HB9GZE/Pub_DIY_Q_BLDCmotorcontroller/1_eagle/STM32F303CBT6_BTN8962TA_V1_0.brd

## EAGLE design 1_eagle/STM32F303CBT6_BTN8962TA_V1_0.brd (2017-02-23)

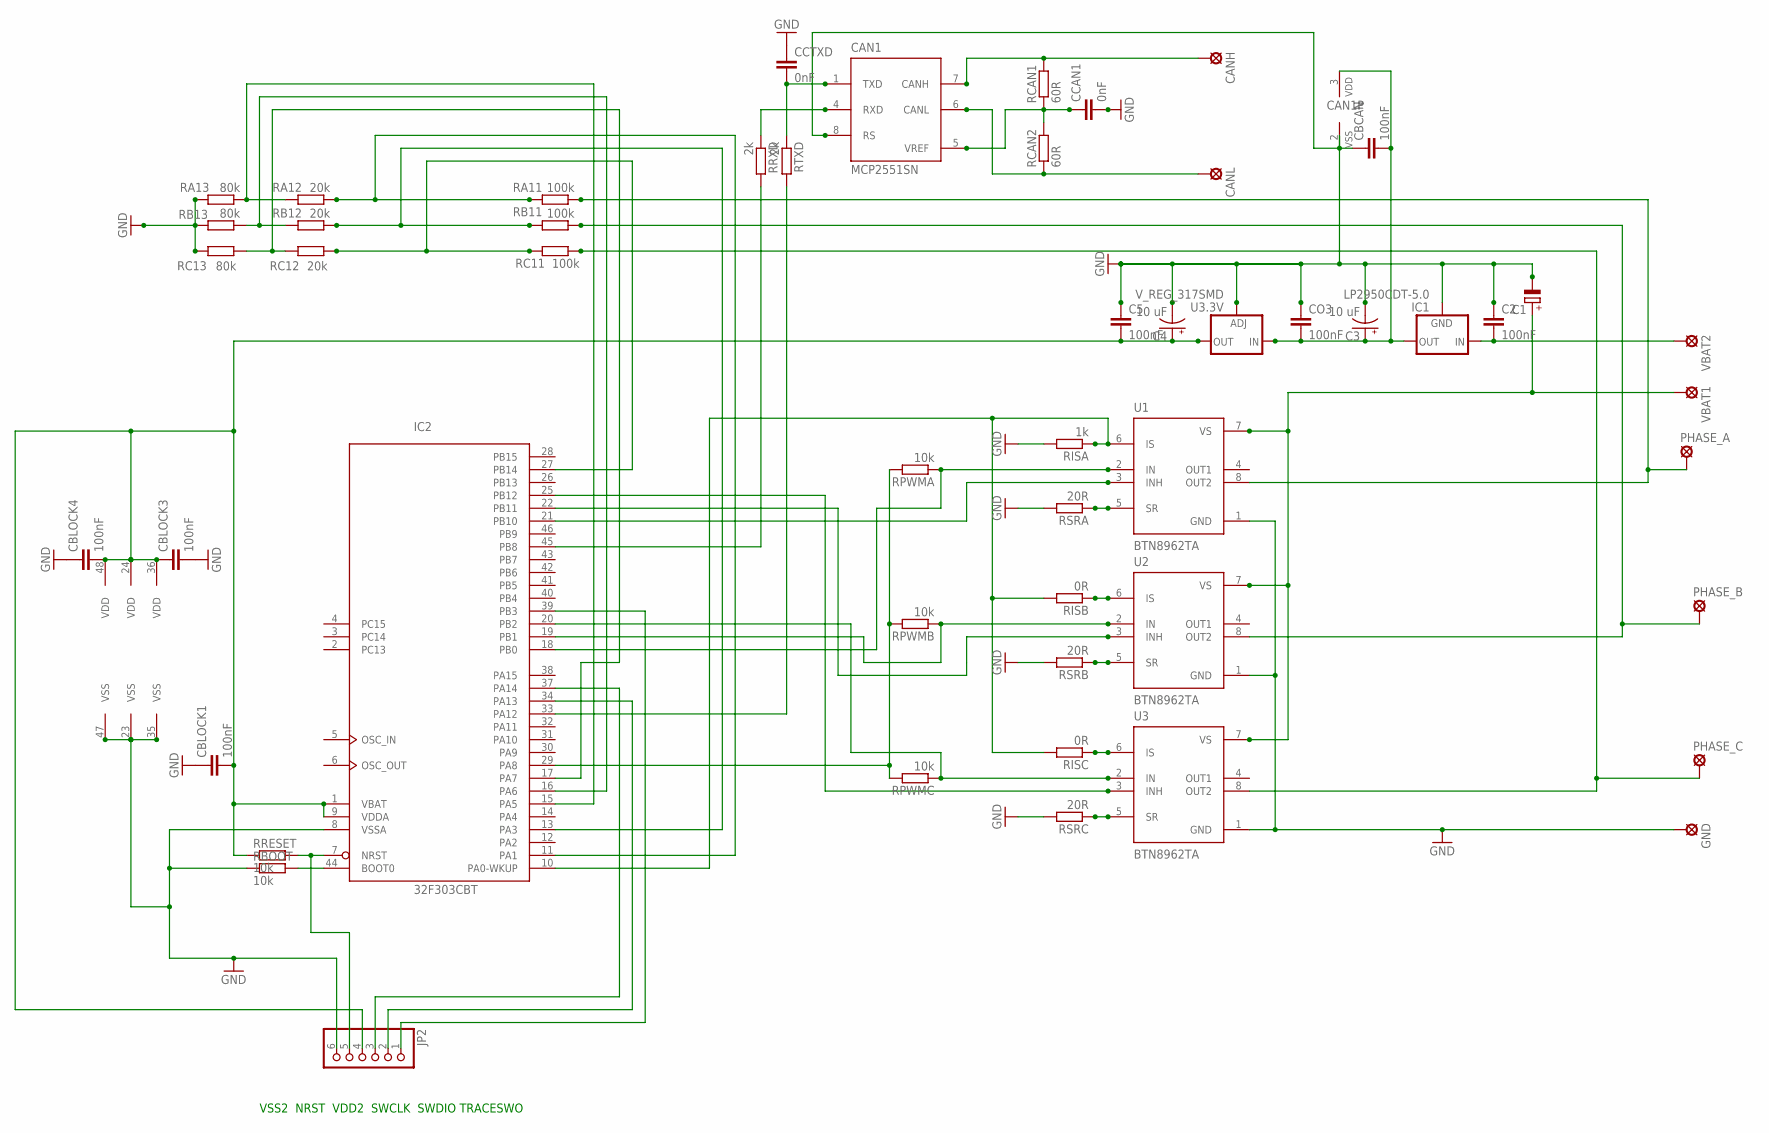
[picture p1: schematic STM32F303CBT6_BTN8962TA_V1_0.sch]

Parts:
C1: CPOL-EUE3.5-10; E3,5-10
C2, C5: 100nF; C0805
C3, C4: 10 uF; PANASONIC_D
CAN1: MCP2551SN; SO-08
CANH: LSP10
CANL: LSP10
CBCAN: 100nF; C0805
CBLOCK1, CBLOCK3, CBLOCK4: 100nF; C0805
CCAN1: 0nF; C0805
CCTXD: 0nF; C0805
CO3: 100nF; C0805
GND: SE14
IC1: LP2950CDT-5.0; DPACK
IC2: 32F303CBT; LQFP48
JP2: PINHD-1X6; 1X06
PHASE_A: SE14
PHASE_B: SE14
PHASE_C: SE14
RA11: 100k; R0805
RA12: 20k; R0805
RA13: 80k; R0805
RB11: 100k; R0805
RB12: 20k; R0805
RB13: 80k; R0805
RBOOT: 10k; R0805
RC11: 100k; R0805
RC12: 20k; R0805
RC13: 80k; R0805
RCAN1, RCAN2: 60R; R0805
RISA: 1k; R0805
RISB: 0R; R0805
RISC: 0R; R0805
RPWMA: 10k; R0805
RPWMB: 10k; R0805
RPWMC: 10k; R0805
RRESET: 10k; R0805
RRXD: 2k; R0805
RSRA: 20R; R0805
RSRB: 20R; R0805
RSRC: 20R; R0805
RTXD: 2k; R0805
U1, U2, U3: BTN8962TA; TO127P1500X440-8N-1
U3.3V: V_REG_317SMD; SOT223
VBAT1, VBAT2: SE14

Connections:
A: IC2.11 (PA1), RA11.2, RA12.1
B: IC2.13 (PA3), RB11.2, RB12.1
C: IC2.27 (PB14), RC11.2, RC12.1
GND: C1.-, C2.1, C3.-, C4.-, C5.1, CAN1.2 (VSS), CAN1.8 (RS), CBCAN.1, CBLOCK1.1, CBLOCK3.2, CBLOCK4.1, CCAN1.2, CCTXD.1, CO3.1, GND.MP, IC1.4 (GND), IC2.8 (VSSA), IC2.23 (VSS), IC2.35 (VSS), IC2.47 (VSS), JP2.6, RA13.2, RB13.2, RBOOT.1, RC13.2, RISA.2, RSRA.2, RSRB.2, RSRC.2, U1.1 (GND), U2.1 (GND), U3.1 (GND), U3.3V.1 (ADJ)
unnamed: PHASE_A.MP, RA11.1, U1.8 (OUT2)
unnamed: PHASE_B.MP, RB11.1, U2.8 (OUT2)
unnamed: PHASE_C.MP, RC11.1, U3.8 (OUT2)
unnamed: C1.+, U1.7 (VS), U2.7 (VS), U3.7 (VS), VBAT1.MP
unnamed: IC2.45 (PB8), RRXD.2
unnamed: RSRA.1, U1.5 (SR)
unnamed: RISB.1, U2.6 (IS)
unnamed: RSRB.1, U2.5 (SR)
unnamed: RISC.1, U3.6 (IS)
unnamed: IC2.10 (PA0-WKUP), RISA.1, RISB.2, RISC.2, U1.6 (IS)
unnamed: RSRC.1, U3.5 (SR)
unnamed: IC2.39 (PB3), JP2.1
unnamed: IC2.19 (PB1), RPWMB.1, U2.2 (IN)
unnamed: IC2.20 (PB2), RPWMC.1, U3.2 (IN)
unnamed: IC2.25 (PB12), U3.3 (INH)
unnamed: IC2.29 (PA8), RPWMA.2, RPWMB.2, RPWMC.2
unnamed: IC2.22 (PB11), U2.3 (INH)
unnamed: IC2.21 (PB10), U1.3 (INH)
unnamed: IC2.18 (PB0), RPWMA.1, U1.2 (IN)
unnamed: IC2.34 (PA13), JP2.2
unnamed: IC2.37 (PA14), JP2.3
unnamed: IC2.33 (PA12), RTXD.2
unnamed: CAN1.4 (RXD), RRXD.1
unnamed: CAN1.6 (CANL), CANL.MP, RCAN2.1
unnamed: CAN1.1 (TXD), CCTXD.2, RTXD.1
unnamed: CAN1.5 (VREF), CCAN1.1, RCAN1.1, RCAN2.2
unnamed: IC2.44 (BOOT0), RBOOT.2
unnamed: C2.2, IC1.1 (IN), VBAT2.MP
unnamed: CAN1.7 (CANH), CANH.MP, RCAN1.2
unnamed: IC2.17 (PA7), RC12.2, RC13.1
unnamed: IC2.16 (PA6), RB12.2, RB13.1
unnamed: IC2.15 (PA5), RA12.2, RA13.1
unnamed: IC2.7 (NRST), JP2.5, RRESET.2
V50: C3.+, CAN1.3 (VDD), CBCAN.2, CO3.2, IC1.3 (OUT), U3.3V.3 (IN)
VDD: C4.+, C5.2, CBLOCK1.2, CBLOCK3.1, CBLOCK4.2, IC2.1 (VBAT), IC2.9 (VDDA), IC2.24 (VDD), IC2.36 (VDD), IC2.48 (VDD), JP2.4, RRESET.1, U3.3V.2 (OUT)

Notes on the sheet:
VSS2 NRST VDD2 SWCLK SWDIO TRACESWO

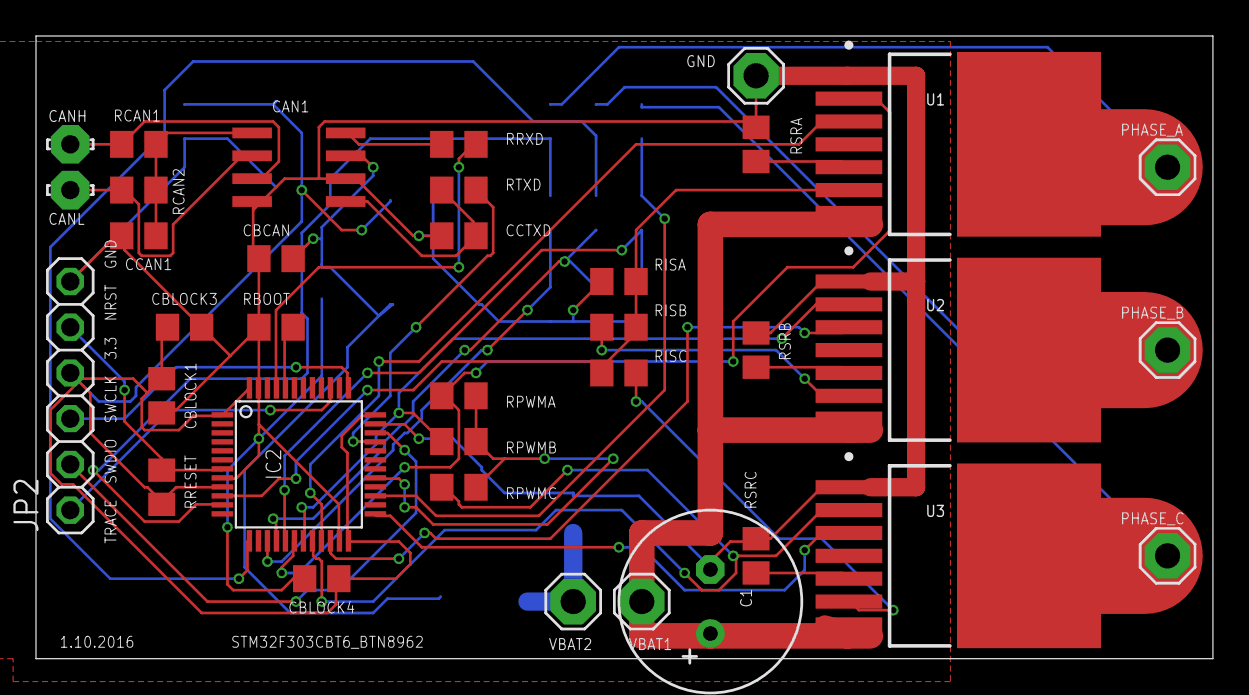
[picture p2: board STM32F303CBT6_BTN8962TA_V1_0.brd from above]

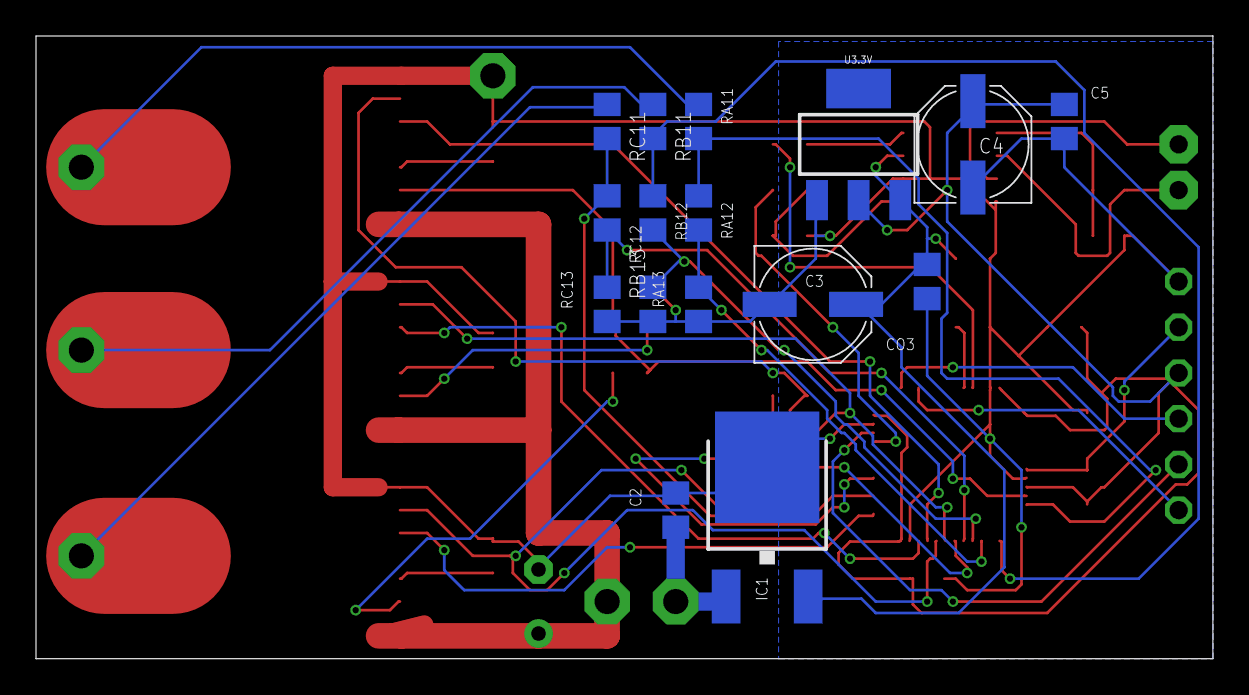
[picture p3: board STM32F303CBT6_BTN8962TA_V1_0.brd from below]

Board: 2 copper layers, 65.4 x 34.6 mm, 52 parts (16 on the bottom side), 39 nets.
