HB9GZE/Pub_DIY_Q_BLDCmotorcontroller/BLDC MC 303CBT BTN_V1.ioc

Mcu.UserName=STM32F303CBTx
PA0.Signal=ADC1_IN1
PA1.Signal=COMP1_INP
PA12.Signal=CAN_TX
PA13.Signal=SYS_JTMS-SWDIO
PA14.Signal=SYS_JTCK-SWCLK
PA3.Signal=COMP2_INP
PA4.Signal=COMP_DAC1_group
PA5.Signal=GPIO_Input
PA6.Signal=GPIO_Input
PA7.Signal=GPIO_Input
PA8.Signal=S_TIM1_CH1
PB0.Signal=GPIO_Input
PB1.Signal=GPIO_Input
PB10.Signal=GPIO_Output
PB11.Signal=GPIO_Output
PB12.Signal=GPIO_Output
PB14.Signal=COMP3_INP
PB2.Signal=GPIO_Input
PB3.Signal=SYS_JTDO-TRACESWO
PB8.Signal=CAN_RX
