HB9GZE/Pub_DIY_Q_BLDCmotorcontroller/(commit log)

2017-02-23 added eagle files...
    [STM32F303CBT6_BTN8962TA_V1_0.brd, STM32F303CBT6_BTN8962TA_V1_0.sch]
2017-08-07 tune BLDC motor controller for faster response...
2017-08-09 new eagle files
    [STM32F303CBT6_BTN8962TA_V1_0.brd, STM32F303CBT6_BTN8962TA_V1_0.sch]
