HB9GZE/Pub_DIY_Q_BLDCmotorcontroller/(notices)

Notices in the files:
Src/main.c:
(C) COPYRIGHT STMicroelectronics *****END OF FILE
parts and their libraries:
SparkFun-Capacitors: Licensing: CC v3.0 Share-Alike You are welcome to use this library for commercial purposes.
